eddysanoli-forks/Robotica-Cuadrupedo/Diseño Mecánico/Cuadrúpedo - Ensamble 3 DOF.png

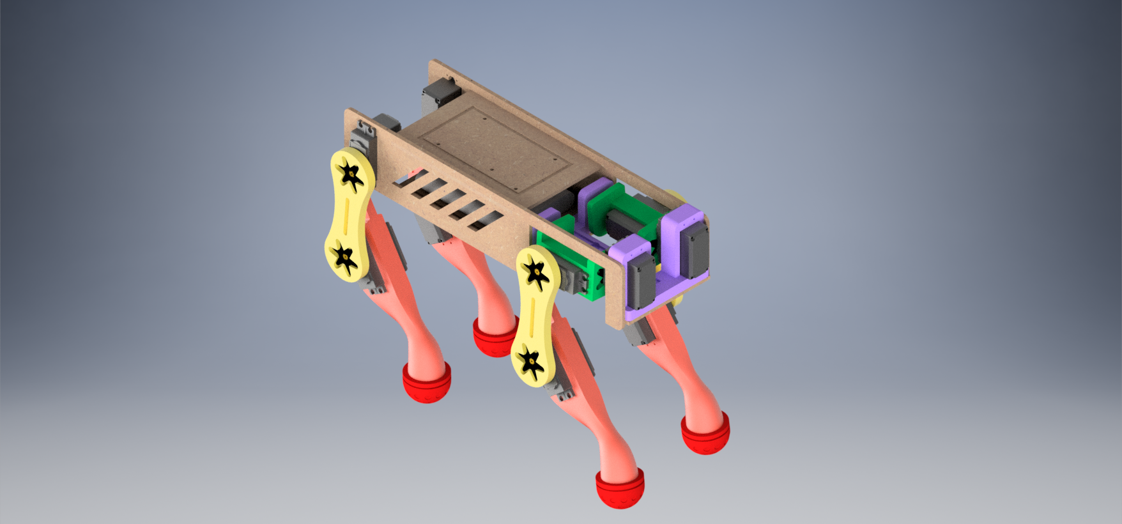
Diseño Mecánico/Cuadrúpedo - Ensamble 3 DOF.png
