eddysanoli-forks/Robotica-Cuadrupedo/Diseño Mecánico/Cuadrúpedo - Ensamble 3 DOF - No Background.png

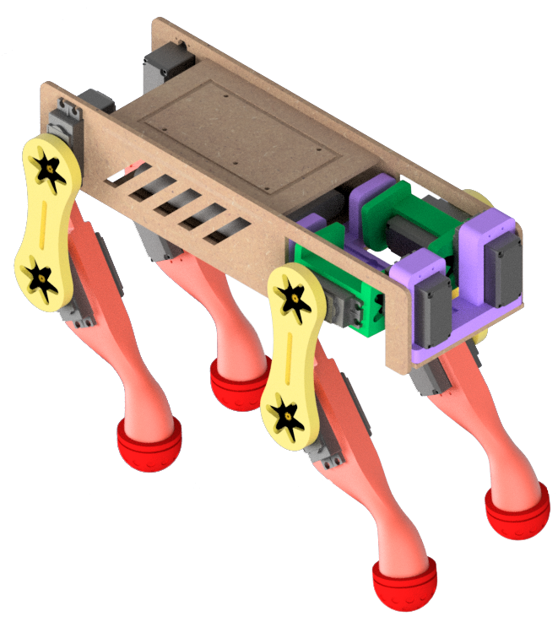
Diseño Mecánico/Cuadrúpedo - Ensamble 3 DOF - No Background.png
