eddysanoli-forks/Robotica-Cuadrupedo/README.md

# Robotica-Cuadrupedo
Diseño mecánico de un robot cuadrúpedo cuyo torso está fabricado a partir de planchas de madera MDF y sus patas consisten de impresiones 3D.
