eddysanoli-forks/Robotica-Cuadrupedo/Proyecto No. 1 - Reporte Generación de Trayectorias.pdf

MT3005 - ROBOTICA I ´

# Proyecto No. 1: Diseño y Control Cinemático de un Cuadrúpedo (Simulación)


### María Fernana Girón (16820) Domenico Dellachiessa (16036) Jacqueline Guarcax (16142) Eduardo Santizo Olivet (16089) Sección 10 10 de mayo de 2020

MT3005 - Proyecto No. 1: Diseño Electrónico de un Cuadrúpedo

## I. Matriz Denavit-Hartenberg

### 1. Modelo del Robot 3D para patas delanteras

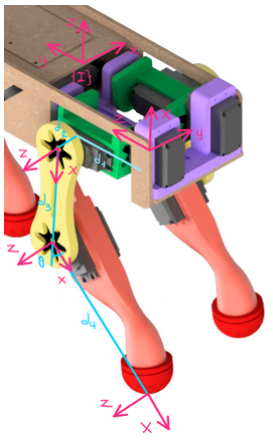
[picture p9: figure]

Figura 1: Patas delanteras del cuadrúpedo

q | θ | b | a | α
q1 | 0 | d1 | 0 | π/2
q2 | π | d2 | d3 | 0
q3 | π/6 | 0 | d4 | 0

Cuadro 1: Parámetros Denavit-Hartenberg

Dimensiones:
d1 = 50mm

d2 = 15mm

d3 = 80mm

d4 = 129mm

2

### 2. Modelo del Robot 2D para patas traseras

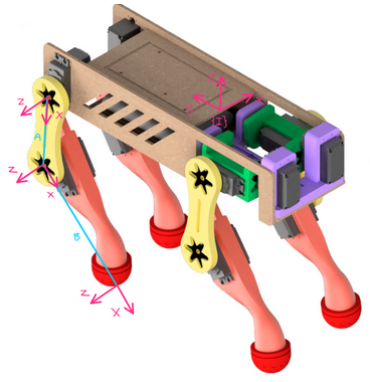
[picture p10: figure]

Figura 2: Patas traseras del cuadrúpedo

q | θ | b | a | α
q1 | π/6 | 0 | A | 0
q2 | 4π/6 | 0 | B | 0

Cuadro 2: Parámetros Denavit-Hartenberg

Dimensiones:
A = 80mm

B = 129mm

Con los parámetros de Denavit-Hartenberg definidos se procedió a definir las patas como objetos SerialLink en matlab. Con los objetos definidos se utilizó la función teach para visualizar y manipular las patas, de esta forma se obtuvo una mejor visión del movimiento que se esperaba que realizaran.

3

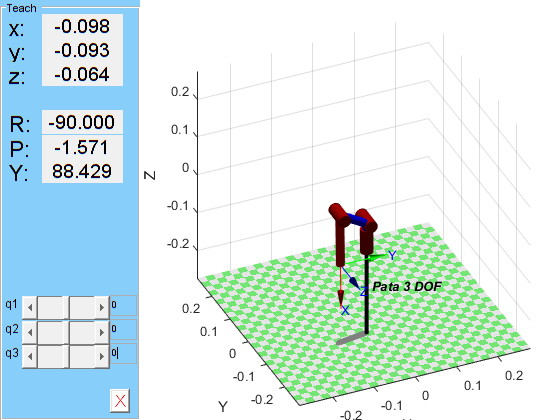
[picture p11: figure]

Figura 3: SerialLink pata delantera

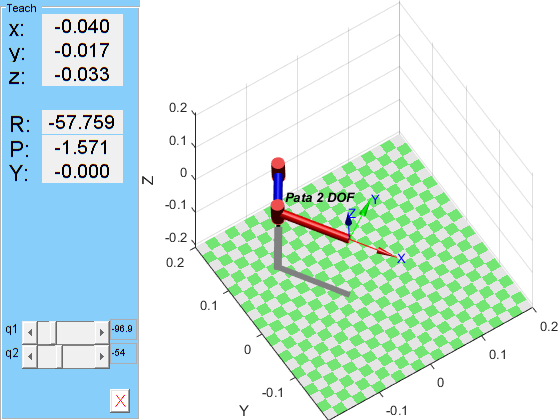
[picture p12: figure]

Figura 4: SerialLink pata trasera

4

## II. Cinemática Directa

Para ambos casos la cinemática directa se obtuvo con la matrices de Denavit-Hartenberg. Inicialmente se obtuvo la matriz de transformación homogénea Aj para los ángulos de Denavit-Hartenberg.

Aj ≡

j−1 Tj = Rotz (θj ) Translz (dj ) Translx (aj ) Rotx (αj ) | (1)

A partir de esto se obtuvo la cinemática directa en forma de matriz de transformación homogénea. Empleando la convención DH, en donde la cinemática directa se define como:

BTE(q) = Y

N

j=1

Aj (qj ) | (2)

Adicionalmente, se emplearon transformaciones de base y de herramienta, según el caso. De esta forma, se consideró la posición inicial de las patas del robot respecto al marco inercial. Y la posición del efector final de la pata, respecto al inicio de la misma.

### Modelo 3D

Matriz DH:

DH =

q(1) | d1 | 0 | pi/2
q(2)+pi | d2 d3 | 0
q(3)+pi/6 | 0 | d4 | 0

Transformación de Base:

ITB =

0.9996 | 0.0274 | 0 | −0.0284
−0.0274 | 0.9992 | 0.0274 −0.0785
0.0008 | −0.0274 0.9996 −0.0251
0 | 0 | 0 | 1.0000

### Modelo 2D

Matriz DH:

DH =

q(1)+pi/6 0 A 0
q(2)+4pi/6 0 B 0

Transformación de Base:

ITB =

0.9981 −0.0548 −0.0274 −0.0640
0.0548 | 0.9985 | 0 | 0.1588
0.0274 −0.0015 | 0.9996 | −0.0341
0 | 0 | 0 | 1.0000

5

## III. Cinemática Inversa

Se empleó la cinemática inversa numérica completa mediante un cálculo iterativo descrito en la ecuación 3. Lo que se busca es acumular las configuraciones pasadas y el error para llegar a la pose final deseada.

qk+1 = qk + J

−1
(qk) ek | (3)

Para el cálculo de la pseudo inversa del jacobiano se seleccionó el de Levenberg-Marquardt
4. Esta decisión se tomó debido a que evita que el algoritmo presente problemas en las singularidades y provee una solución con mayor continuidad. Este comportamiento es útil porque se desea que el robot presente movimientos naturales.

J

† → J

>

JJ> + λ
2
I

−1
(4)

En cuanto al cálculo del error se seleccionó una tolerancia de 1x10⁻⁶ para la posición y 1x10⁻⁵ para la orientación. El error está descrito por la siguiente ecuación:

ek =

ep[k]
eo[k]
(5)

En donde el error de posición esta definido conforme a 6 y el de orientación respecto a 8 derivado del cálculo efectuado mediante cuaterniones.

ek = od − o (qk) | (6)

Qe[k] = Qd ∗ Q⁻¹
(qk) = {ηe[k], e[k]} | (7)
eo[k] = e[k] | (8)

Cabe resaltar que si la configuración inicial se encuentra más cercana a la configuración final se obtendrán trayectorias más suaves. Esta idea es la que permite la generación de la trayectoria deseada dándole así mayor importancia a este procedimiento.

## IV. Generación de trayectoria

Para generar la trayectoria inicialmente se plantearon los puntos necesarios para generar el movimiento deseado para las patas delanteras y traseras. En el caso de las patas traseras, el movimiento es únicamente en dos dimensiones. Mientras que a las patas delanteras, se les agregó un grado más de libertad para mejorar la locomoción del cuadrúpedo.
Con los puntos establecidos se utilizó la función mstraj de la Robotic Toolbox para generar la trayectoria. Seguido de esto, se planteó la cinemática inversa para cada conjunto de coordenadas generado en la trayectoria y se procedió a almacenar las configuraciones resultantes.

6

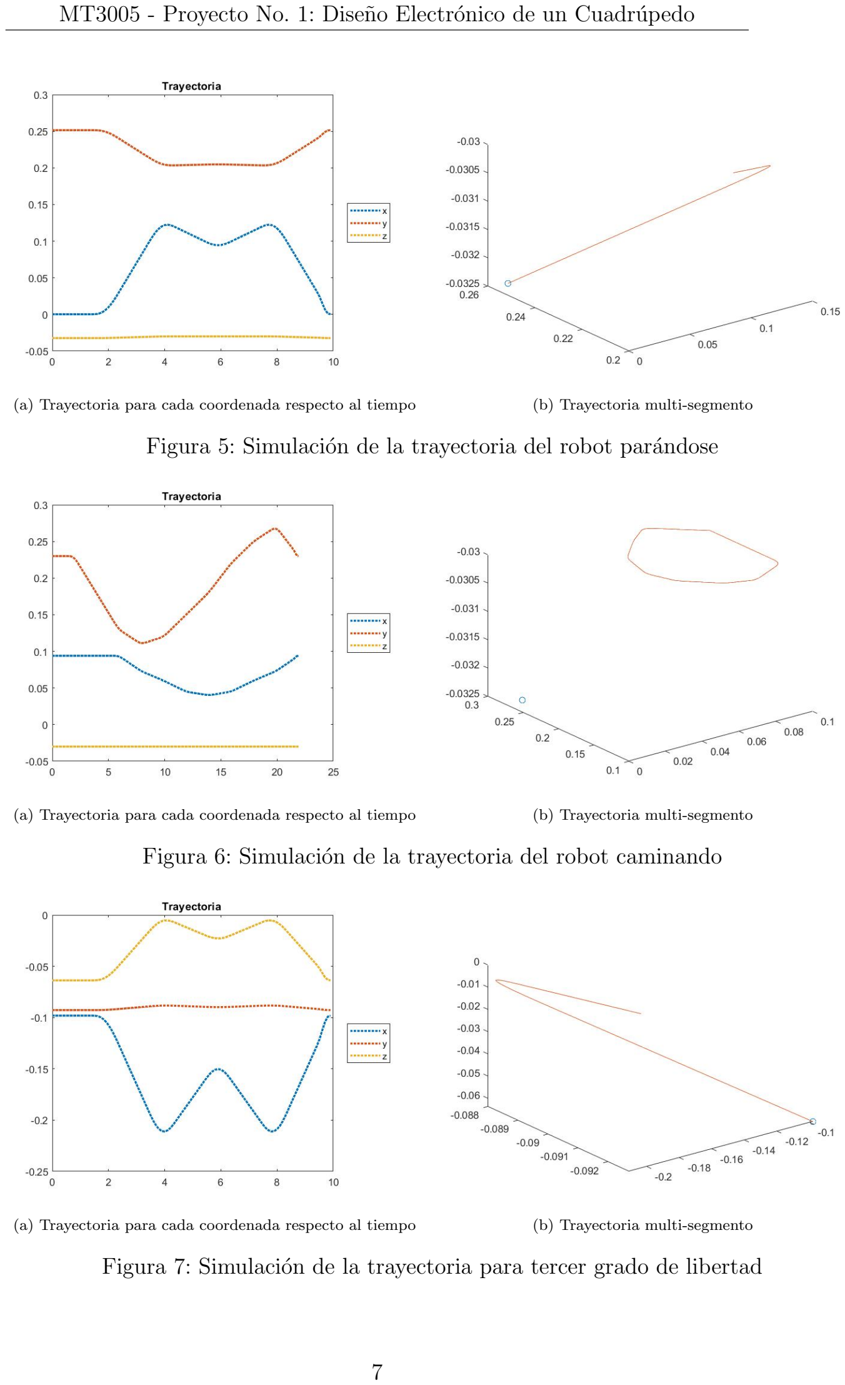
[picture p13: page 7]

(a) Trayectoria para cada coordenada respecto al tiempo | (b) Trayectoria multi-segmento

Figura 5: Simulación de la trayectoria del robot parándose

(a) Trayectoria para cada coordenada respecto al tiempo | (b) Trayectoria multi-segmento

Figura 6: Simulación de la trayectoria del robot caminando

(a) Trayectoria para cada coordenada respecto al tiempo | (b) Trayectoria multi-segmento

Figura 7: Simulación de la trayectoria para tercer grado de libertad

7
