eddysanoli-forks/Robotica-Cuadrupedo/Diseño Mecánico/Servo MG996R/Dimensiones Servo.jpg

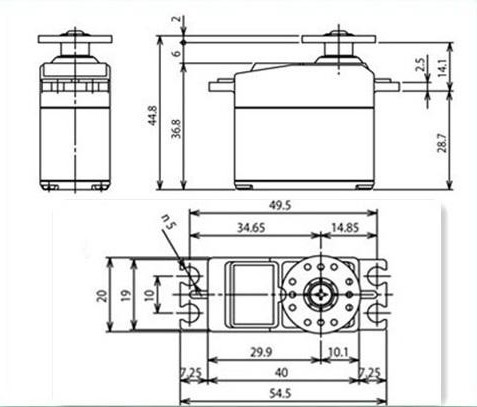
Diseño Mecánico/Servo MG996R/Dimensiones Servo.jpg
