eddysanoli-forks/Robotica-Cuadrupedo/quadruped-gaits.jpg

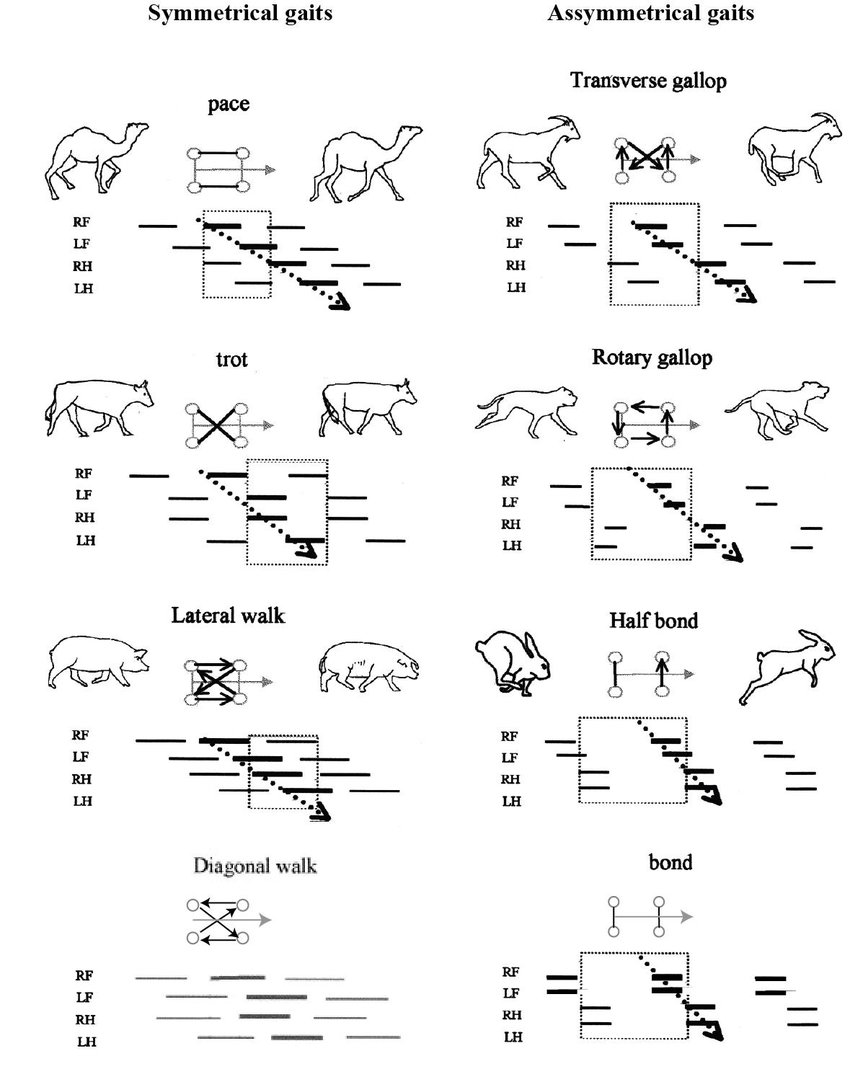
quadruped-gaits.jpg
