eddysanoli-forks/Robotica-Cuadrupedo/Diseño Mecánico/Fabricación - Impresión en 3D y Corte Láser/Cuerpo - Acople Hombro/Cuerpo - Acople Hombro - Sección Servo.stl

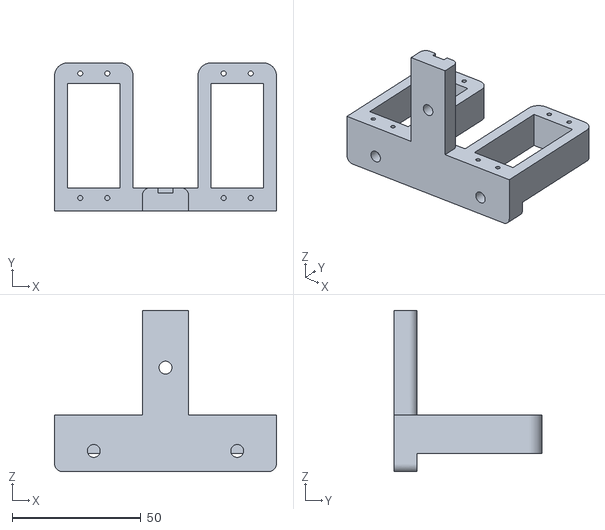
[picture p16: CAD file, 2020-10-24]
Diseño Mecánico/Fabricación - Impresión en 3D y Corte Láser/Cuerpo - Acople Hombro/Cuerpo - Acople Hombro - Sección Servo.stl
86.2 x 57.5 x 62.5
