eddysanoli-forks/Robotica-Cuadrupedo/Diseño Mecánico/Fabricación - Impresión en 3D y Corte Láser/Pata - Brazo - Impresión 3D.stl

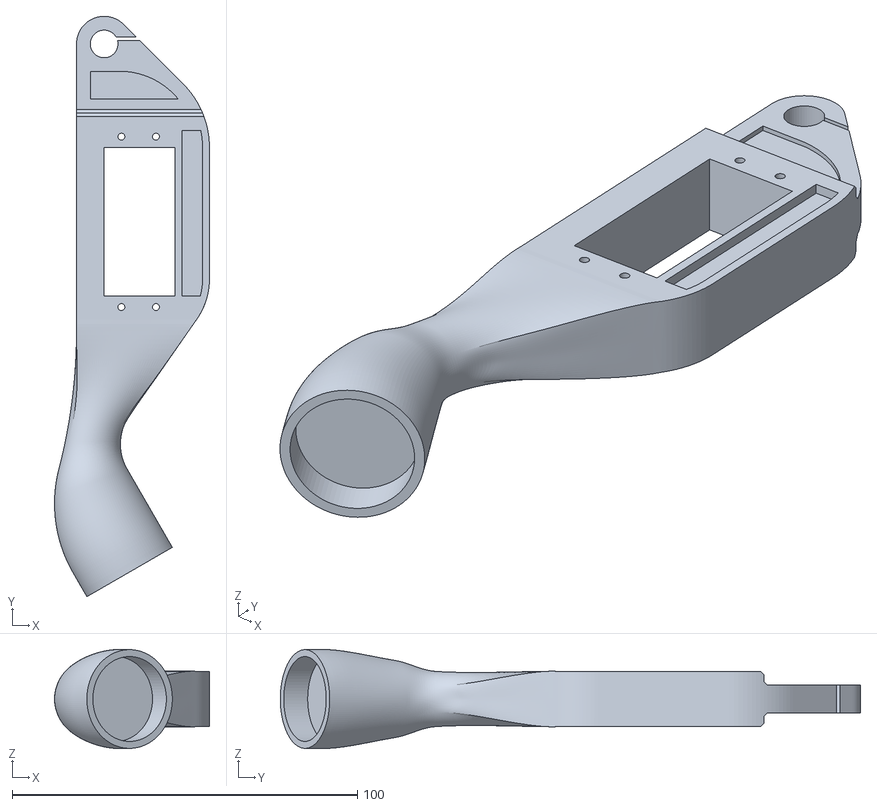
[picture p17: CAD file, 2020-10-24]
Diseño Mecánico/Fabricación - Impresión en 3D y Corte Láser/Pata - Brazo - Impresión 3D.stl
44.9 x 168.0 x 28.8
