eddysanoli-forks/Robotica-Cuadrupedo/Diseño Mecánico/Fabricación - Impresión en 3D y Corte Láser/Pata - Hombro/Pata - Hombro.stl

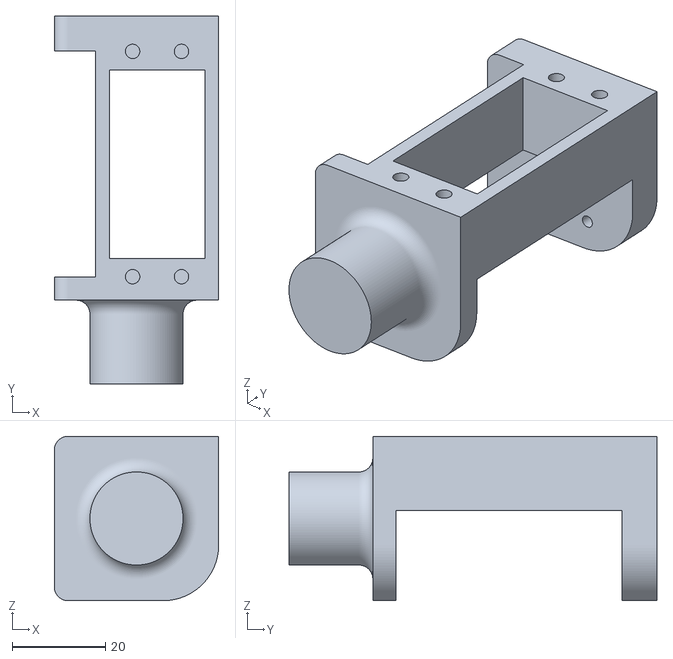
[picture p18: CAD file, 2020-10-24]
Diseño Mecánico/Fabricación - Impresión en 3D y Corte Láser/Pata - Hombro/Pata - Hombro.stl
35.3 x 79.0 x 35.3
