eddysanoli-forks/Robotica-Cuadrupedo/Diseño Mecánico/Fabricación - Impresión en 3D y Corte Láser/Cuerpo - Acople Hombro/Cuerpo - Acople Hombro - Sección Eje Circular.stl

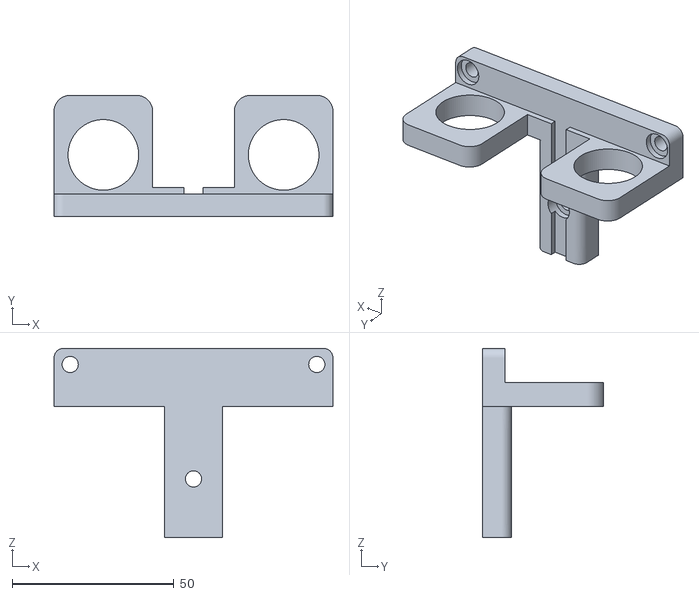
[picture p19: CAD file, 2020-10-24]
Diseño Mecánico/Fabricación - Impresión en 3D y Corte Láser/Cuerpo - Acople Hombro/Cuerpo - Acople Hombro - Sección Eje Circular.stl
86.2 x 37.5 x 58.5
