eddysanoli-forks/Robotica-Cuadrupedo/Diseño Mecánico/Fabricación - Impresión en 3D y Corte Láser/Pata - Antebrazo.stl

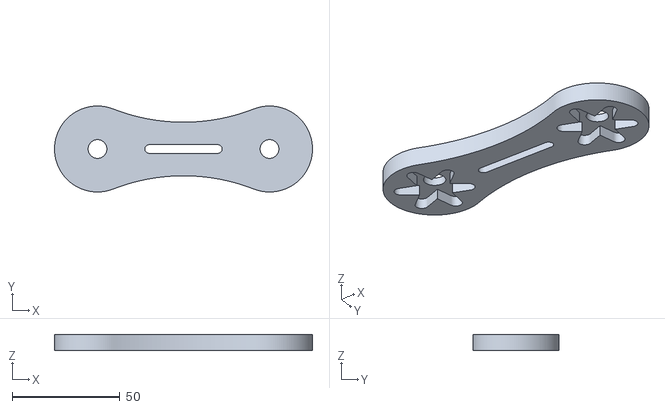
[picture p20: CAD file, 2020-10-24]
Diseño Mecánico/Fabricación - Impresión en 3D y Corte Láser/Pata - Antebrazo.stl
120.0 x 40.0 x 7.55
