eddysanoli-forks/Robotica-Cuadrupedo/(list of files, cad)

Other CAD files:
Diseño Mecánico/Cuadrúpedo - Ensamble 3 DOF.iam
Diseño Mecánico/Cuadrúpedo V1/Cuerpo - Ensamble.iam
Diseño Mecánico/Cuadrúpedo V1/Cuerpo - Lateral.ipt
Diseño Mecánico/Cuadrúpedo V1/Cuerpo - Lateral.sync-conflict-20200301-175627-ARIG6ZN.ipt
Diseño Mecánico/Cuadrúpedo V1/Cuerpo - Unión Laterales.ipt
Diseño Mecánico/Cuadrúpedo V1/Ensamble - Explosión.ipn
Diseño Mecánico/Cuadrúpedo V1/OldVersions/Cuerpo - Lateral.0009.ipt
Diseño Mecánico/Cuadrúpedo V1/Pata - Antebrazo_MIR.ipt
Diseño Mecánico/Cuadrúpedo V1/Pata - Antebrazo_MIR1.ipt
Diseño Mecánico/Cuadrúpedo V1/Pata - Brazo_MIR.ipt
Diseño Mecánico/Cuadrúpedo V1/Pata - Brazo_MIR1.ipt
Diseño Mecánico/Cuadrúpedo V1/Pata - Brazo_MIR1_MIR.ipt
Diseño Mecánico/Cuadrúpedo V1/Pata - Ensamble Trasero.iam
Diseño Mecánico/Cuadrúpedo V1/Pata - Ensamble Trasero_MIR.iam
Diseño Mecánico/Cuadrúpedo V1/Pata - Ensamble_MIR.iam
Diseño Mecánico/Cuadrúpedo V1/Pata - Soporte Antebrazo.ipt
Diseño Mecánico/Cuadrúpedo V1/Plano - Explosión.idw
Diseño Mecánico/Cuadrúpedo V1/Servo - Componente.ipt
Diseño Mecánico/Cuadrúpedo V1/Servo - Componente_MIR.ipt
Diseño Mecánico/Cuadrúpedo V1/Servo - Componente_MIR1.ipt
Diseño Mecánico/Cuadrúpedo V1/Servo - Componente_MIR1_MIR.ipt
Diseño Mecánico/Cuadrúpedo V1/Servo - Soporte Base.ipt
Diseño Mecánico/Cuerpo - Acople Hombro - Sección Eje Circular.ipt
Diseño Mecánico/Cuerpo - Acople Hombro - Sección Servo.ipt
Diseño Mecánico/Cuerpo - Acople Hombro.ipt
Diseño Mecánico/Cuerpo - Base Arduino.ipt
Diseño Mecánico/Cuerpo - Base Batería.ipt
Diseño Mecánico/Cuerpo - Batería.ipt
Diseño Mecánico/Cuerpo - Lateral.ipt
Diseño Mecánico/OldVersions/Acople circular.0004.ipt
Diseño Mecánico/OldVersions/Base.0005.ipt
Diseño Mecánico/OldVersions/Corte.0003.idw
Diseño Mecánico/OldVersions/Cuadrúpedo - Ensamble 2 DOF.0022.iam
Diseño Mecánico/OldVersions/Cuadrúpedo - Ensamble 3 DOF.0012.iam
Diseño Mecánico/OldVersions/Cuadrúpedo - Ensamble.0019.iam
Diseño Mecánico/OldVersions/Cuerpo - Acople Hombro - Sección Eje Circular.0024.ipt
Diseño Mecánico/OldVersions/Cuerpo - Acople Hombro - Sección Servo.0025.ipt
Diseño Mecánico/OldVersions/Cuerpo - Acople Hombro Split.0023.ipt
Diseño Mecánico/OldVersions/Cuerpo - Acople Hombro.0023.ipt
Diseño Mecánico/OldVersions/Cuerpo - Base Arduino.0008.ipt
Diseño Mecánico/OldVersions/Cuerpo - Base Batería.0018.ipt
Diseño Mecánico/OldVersions/Cuerpo - Base.0019.ipt
Diseño Mecánico/OldVersions/Cuerpo - Ensamble.0023.iam
Diseño Mecánico/OldVersions/Cuerpo - Lateral.0021.ipt
Diseño Mecánico/OldVersions/Cuerpo - LateralPrueba.0007.ipt
Diseño Mecánico/OldVersions/Cuerpo - LateralPrueba.0011.ipt
Diseño Mecánico/OldVersions/Cuerpo - Unión Laterales.0004.ipt
Diseño Mecánico/OldVersions/Cuerpo-Rediseno-Ensamble.0014.iam
Diseño Mecánico/OldVersions/Eje.0005.ipt
Diseño Mecánico/OldVersions/Ensamble - Explosión.0005.ipn
Diseño Mecánico/OldVersions/Ensamble_Pierna.0009.iam
Diseño Mecánico/OldVersions/Ensamble_Pierna.0010.iam
Diseño Mecánico/OldVersions/Ensamble_Pierna_delantera.0003.iam
Diseño Mecánico/OldVersions/Ensamble_cuerpo.0010.iam
Diseño Mecánico/OldVersions/MG_996R.0004.iam
Diseño Mecánico/OldVersions/Medio.0004.ipt
Diseño Mecánico/OldVersions/Part 18.0001.ipt
Diseño Mecánico/OldVersions/Part 6.0001.ipt
Diseño Mecánico/OldVersions/Part 7.0001.ipt
Diseño Mecánico/OldVersions/Pata - Antebrazo.0020.ipt
Diseño Mecánico/OldVersions/Pata - Antebrazo_MIR.0002.ipt
Diseño Mecánico/OldVersions/Pata - Antebrazo_MIR.0003.ipt
Diseño Mecánico/OldVersions/Pata - Antebrazo_MIR1.0003.ipt
Diseño Mecánico/OldVersions/Pata - Antebrazo_MIR1.0004.ipt
Diseño Mecánico/OldVersions/Pata - Brazo - Impresión 3D.0017.ipt
Diseño Mecánico/OldVersions/Pata - Brazo - Pata Ninjaflex.0021.ipt
Diseño Mecánico/OldVersions/Pata - Brazo - Pata Taco Hule.0017.ipt
Diseño Mecánico/OldVersions/Pata - Brazo.0006.ipt
Diseño Mecánico/OldVersions/Pata - Brazo.0012.ipt
Diseño Mecánico/OldVersions/Pata - Brazo_MIR.0002.ipt
Diseño Mecánico/OldVersions/Pata - Brazo_MIR.0003.ipt
Diseño Mecánico/OldVersions/Pata - Brazo_MIR1.0003.ipt
Diseño Mecánico/OldVersions/Pata - Brazo_MIR1.0004.ipt
Diseño Mecánico/OldVersions/Pata - Brazo_MIR1_MIR.0002.ipt
Diseño Mecánico/OldVersions/Pata - Ensamble 3 DOF.0012.iam
Diseño Mecánico/OldVersions/Pata - Ensamble 3 DOF.0013.iam
Diseño Mecánico/OldVersions/Pata - Ensamble Trasero.0002.iam
Diseño Mecánico/OldVersions/Pata - Ensamble Trasero.0006.iam
Diseño Mecánico/OldVersions/Pata - Ensamble Trasero_MIR.0003.iam
Diseño Mecánico/OldVersions/Pata - Ensamble.0019.iam
Diseño Mecánico/OldVersions/Pata - Ensamble_Lado_Izq.0006.iam
Diseño Mecánico/OldVersions/Pata - Ensamble_Lado_Izq.0007.iam
Diseño Mecánico/OldVersions/Pata - Ensamble_MIR.0003.iam
Diseño Mecánico/OldVersions/Pata - Hombro Mirror.0002.ipt
Diseño Mecánico/OldVersions/Pata - Hombro.0009.ipt
Diseño Mecánico/OldVersions/Pata - Pie - Liso.0001.ipt
Diseño Mecánico/OldVersions/Pata - Pie - Textura.0005.ipt
Diseño Mecánico/OldVersions/Pata - Soporte Antebrazo.0005.ipt
Diseño Mecánico/OldVersions/Pierna2.0004.ipt
Diseño Mecánico/OldVersions/Pierna2.0005.ipt
Diseño Mecánico/OldVersions/Plano - Corte Láser.0013.idw
Diseño Mecánico/OldVersions/Plano - Explosión.0006.idw
Diseño Mecánico/OldVersions/Robocatto - Antebrazo.0001.ipt
Diseño Mecánico/OldVersions/SG90.0002.ipt
Diseño Mecánico/OldVersions/Servo - Componente.0003.ipt
Diseño Mecánico/OldVersions/Servo - Componente_MIR.0001.ipt
Diseño Mecánico/OldVersions/Servo - Componente_MIR1.0002.ipt
Diseño Mecánico/OldVersions/Servo - Componente_MIR1_MIR.0001.ipt
Diseño Mecánico/OldVersions/Servo - Soporte Base.0002.ipt
Diseño Mecánico/OldVersions/Sevo arm TowerPro SG-5010.0002.ipt
Diseño Mecánico/OldVersions/Top.0005.ipt
Diseño Mecánico/OldVersions/cuerpo-base-bateria.0001.ipt
Diseño Mecánico/OldVersions/lateral.0001.ipt
Diseño Mecánico/OldVersions/lateral1.0013.ipt
Diseño Mecánico/OldVersions/lateral1.0014.ipt
Diseño Mecánico/OldVersions/leg1 _1_.0001.iam
Diseño Mecánico/OldVersions/leg1 _2_.0001.iam
Diseño Mecánico/OldVersions/leg2 _1_.0001.iam
Diseño Mecánico/OldVersions/leg2 _2_.0001.iam
Diseño Mecánico/OldVersions/pierna1.0003.ipt
Diseño Mecánico/OldVersions/pierna1.0004.ipt
Diseño Mecánico/OldVersions/pierna1_2.0004.ipt
Diseño Mecánico/OldVersions/pierna1_2.0005.ipt
Diseño Mecánico/OldVersions/servo.0001.ipt
Diseño Mecánico/OldVersions/servo.0002.ipt
Diseño Mecánico/OldVersions/soporte servo base.0006.ipt
Diseño Mecánico/OldVersions/soporte servo base.0007.ipt
Diseño Mecánico/OldVersions/total.0002.iam
Diseño Mecánico/OldVersions/union_lateral.0005.ipt
Diseño Mecánico/OldVersions/union_lateral.0006.ipt
Diseño Mecánico/Pata - Antebrazo.ipt
Diseño Mecánico/Pata - Brazo - Pata Ninjaflex.ipt
Diseño Mecánico/Pata - Brazo - Pata Taco Hule.ipt
Diseño Mecánico/Pata - Ensamble 3 DOF.iam
Diseño Mecánico/Pata - Hombro Mirror.ipt
Diseño Mecánico/Pata - Hombro.ipt
Diseño Mecánico/Pata - Pie - Textura.ipt
Diseño Mecánico/Plano - Corte Láser.idw
Diseño Mecánico/Servo MG996R/OldVersions/Servo MG996R - Ensamble - Sin Flor.0006.iam
Diseño Mecánico/Servo MG996R/OldVersions/Servo MG996R - Ensamble.0005.iam
Diseño Mecánico/Servo MG996R/Servo MG996R - Ensamble - Sin Flor.iam
Diseño Mecánico/Servo MG996R/Servo MG996R - Ensamble.iam
Diseño Mecánico/Servo MG996R/TowerPro SG5010 - Acople Circular.ipt
Diseño Mecánico/Servo MG996R/TowerPro SG5010 - Acople Hélice.ipt
Diseño Mecánico/Servo MG996R/TowerPro SG5010 - Base.ipt
Diseño Mecánico/Servo MG996R/TowerPro SG5010 - Eje.ipt
Diseño Mecánico/Servo MG996R/TowerPro SG5010 - Medio.ipt
Diseño Mecánico/Servo MG996R/TowerPro SG5010 - Tapa Superior.ipt
