eddysanoli-forks/Robotica-Cuadrupedo/Diseño Mecánico/Cuadrúpedo V1/Plano - Corte Láser.pdf

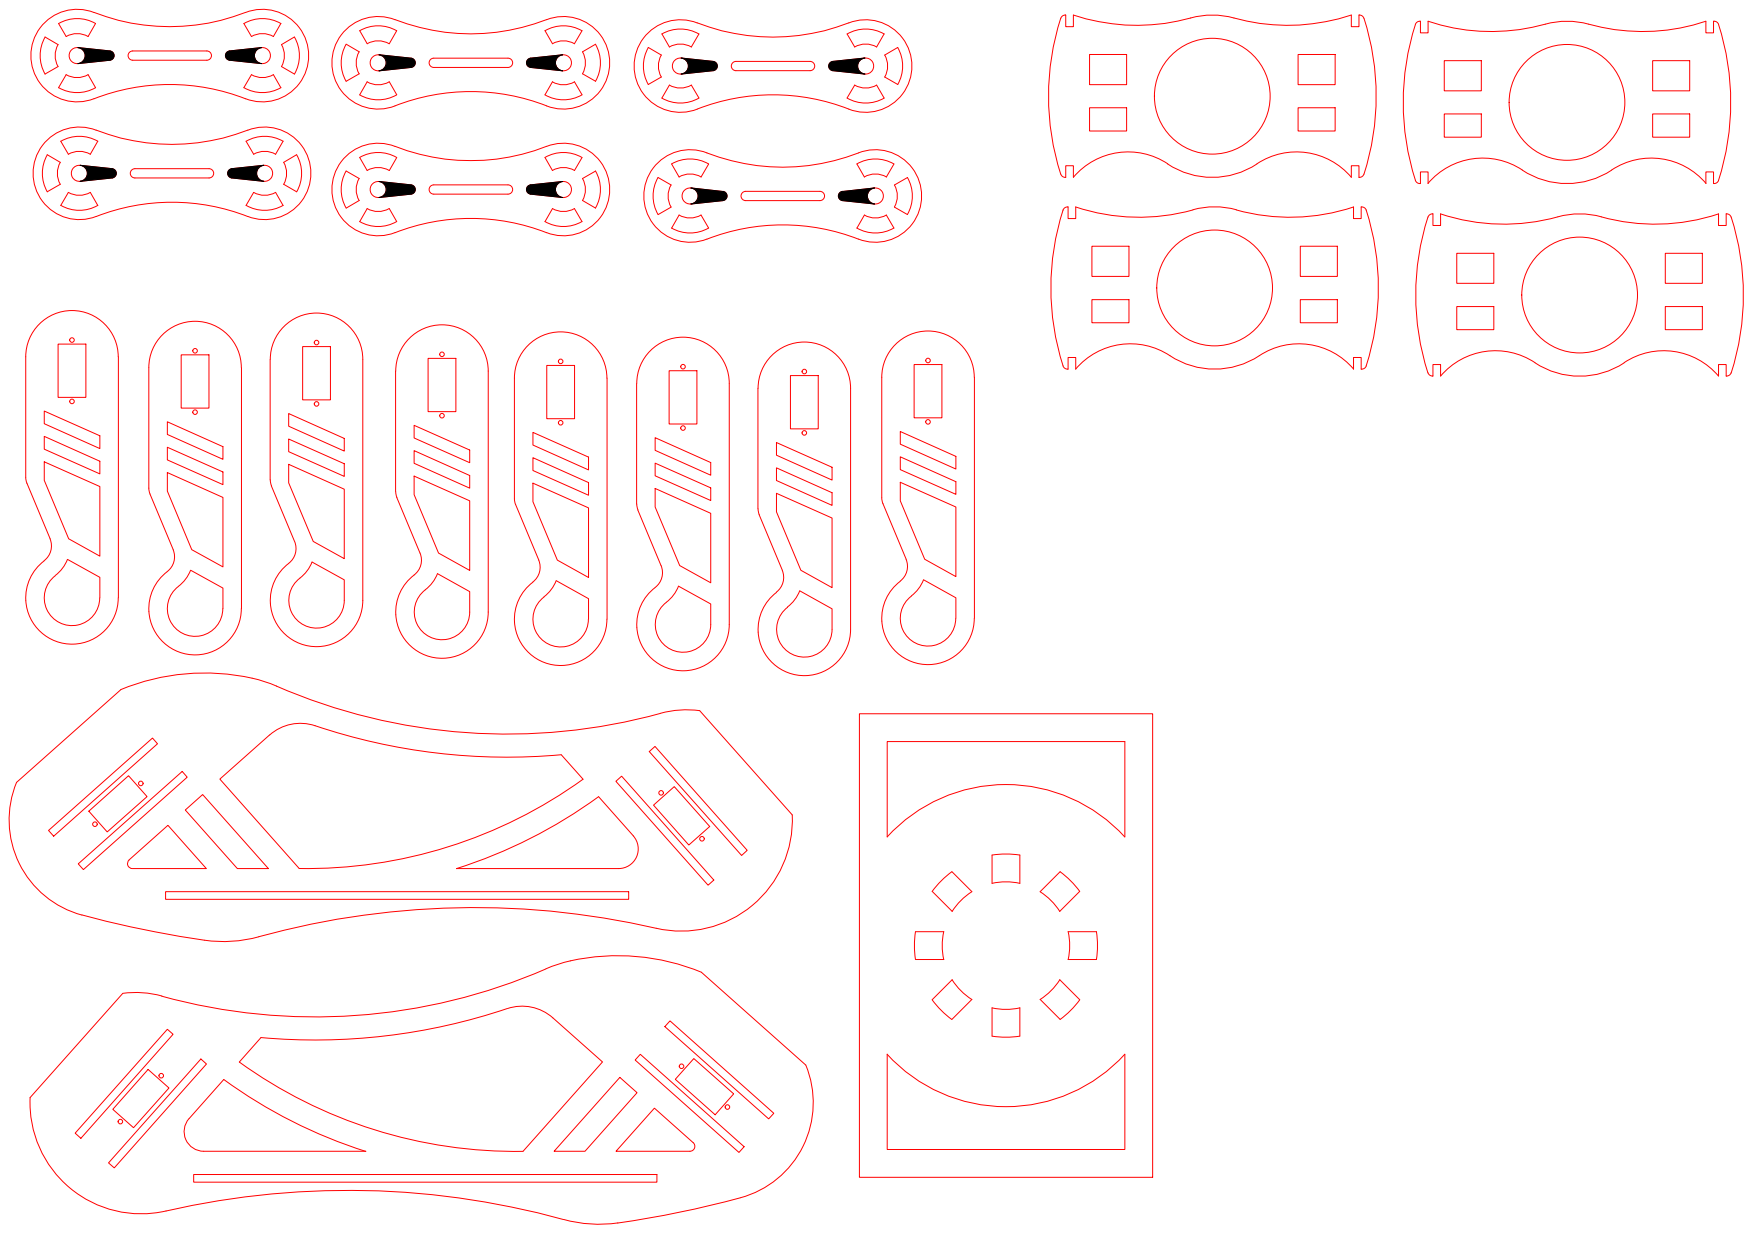
[picture p21: page 1]
