eddysanoli-forks/Robotica-Cuadrupedo/Diseño Mecánico/Pata - Ensamble 3 DOF - No Background.png

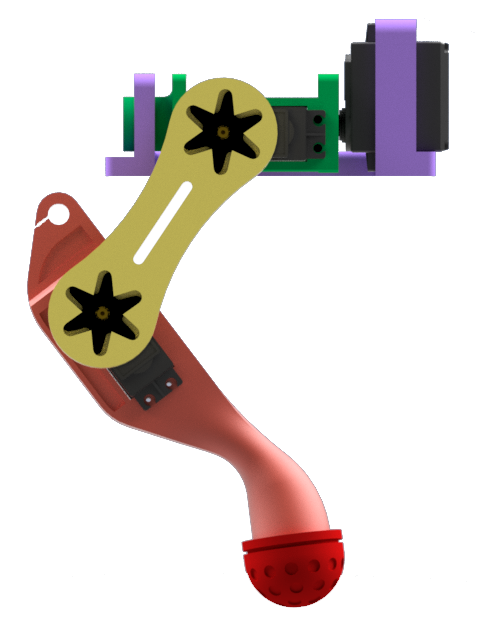
Diseño Mecánico/Pata - Ensamble 3 DOF - No Background.png
