eddysanoli-forks/Robotica-Cuadrupedo/Diseño Mecánico/Pata - Ensamble 3 DOF.png

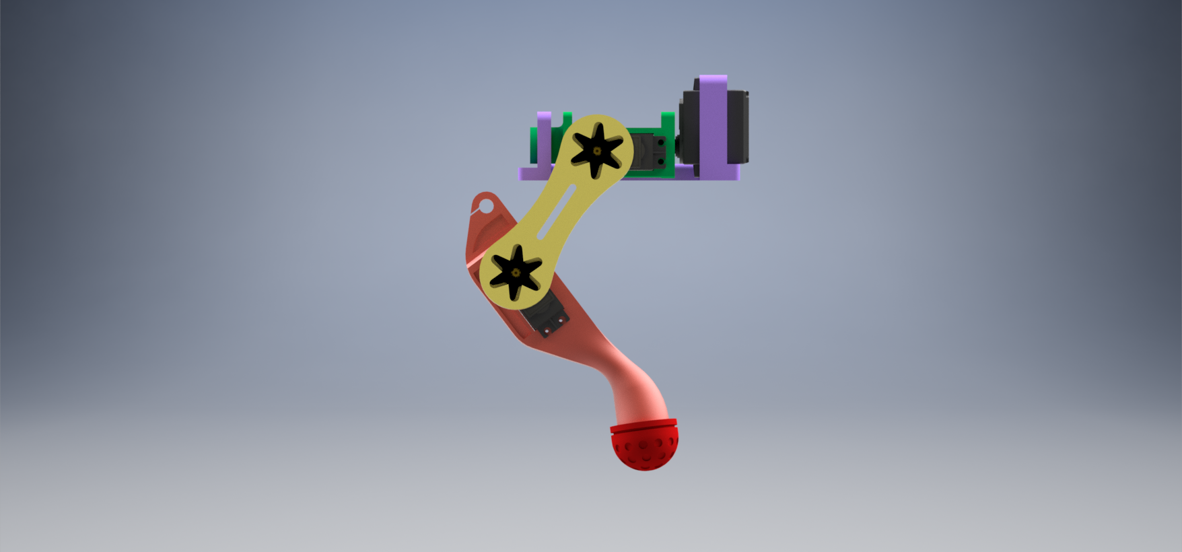
Diseño Mecánico/Pata - Ensamble 3 DOF.png
