eddysanoli-forks/Robotica-Cuadrupedo/(commit log)

2020-10-24 Literatura y Programación
    Literatura y programación necesaria para hacer funcionar el cuadrúpedo. Esto no solo incluye los libros utilizados como referencia, sino también las simulaciones en Matlab de la cinemática directa e inversa del robot. En esta iteración del diseño el robot simplemente es capaz de pararse y sentarse.
2020-10-24 Diseño mecánico
    Piezas diseñadas en inventor para el robot cuadrúpedo. Esto no solo incluyen las piezas que se imprimirán en 3D (con geometrías más complejas) sino que también aquellas que se recortarán con láser.
    [Cuadrúpedo - Ensamble 3 DOF.iam, Cuerpo - Acople Hombro - Sección Eje Circular.ipt, Cuerpo - Acople Hombro - Sección Eje Circular.stl, Cuerpo - Acople Hombro - Sección Servo.ipt, Cuerpo - Acople Hombro - Sección Servo.stl, Cuerpo - Acople Hombro.ipt, Cuerpo - Base Arduino.ipt, Cuerpo - Base Batería.ipt]
2020-10-24 Diseño Mecánico V1
    Con fines de preservación se incluye el diseño mecánico de la primera iteración del robot cuadrúpedo, la cual estaba fabricada en su totalidad de madera MDF.
    [Cuerpo - Ensamble.iam, Cuerpo - Lateral.0009.ipt, Cuerpo - Lateral.ipt, Cuerpo - Lateral.sync-conflict-20200301-175627-ARIG6ZN.ipt, Cuerpo - Unión Laterales.ipt, Ensamble - Explosión.ipn, Pata - Antebrazo_MIR.ipt, Pata - Antebrazo_MIR1.ipt]
2020-10-25 Backup de Piezas Actuales
    Backup utilizado por Inventor en caso las piezas editadas se pierdan.
    [Acople circular.0004.ipt, Base.0005.ipt, Corte.0003.idw, Cuadrúpedo - Ensamble 2 DOF.0022.iam, Cuadrúpedo - Ensamble 3 DOF.0012.iam, Cuadrúpedo - Ensamble.0019.iam, Cuerpo - Acople Hombro - Sección Eje Circular.0024.ipt, Cuerpo - Acople Hombro - Sección Servo.0025.ipt]
